Martin1701/AEEPROG/PCB/USB_mini_board.brd

## EAGLE design PCB/USB_mini_board.brd (2024-07-10)

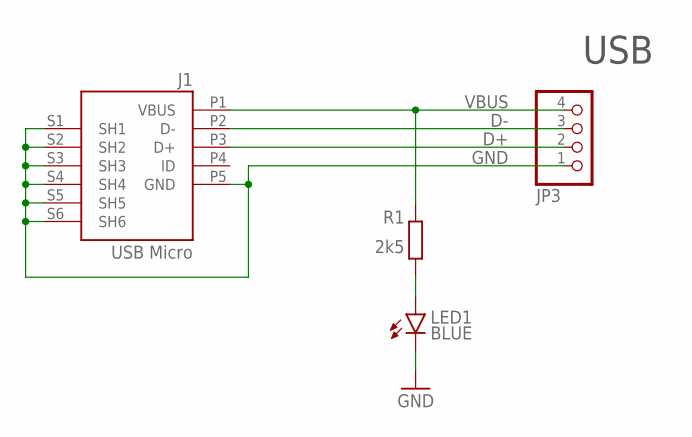
[picture p1: schematic USB_mini_board.sch]

Parts:
J1: USB Micro; CON2_USB_MICRO_B_AT
JP3: PINHD-1X4; 1X04
LED1: BLUE; CHIP-LED0805
R1: 2k5; R1206

Connections:
D+: J1.P3 (D+), JP3.2
D-: J1.P2 (D-), JP3.3
GND: J1.P5 (GND), J1.S1 (SH1), J1.S2 (SH2), J1.S3 (SH3), J1.S4 (SH4), J1.S5 (SH5), J1.S6 (SH6), JP3.1, LED1.C
unnamed: LED1.A, R1.2
VBUS: J1.P1 (VBUS), JP3.4, R1.1

Notes on the sheet:
USB

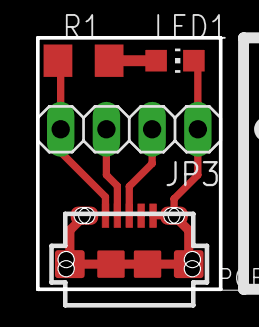
[picture p2: board USB_mini_board.brd from above]

Board: 2 copper layers, 10.2 x 14.0 mm, 4 parts (0 on the bottom side), 5 nets.
