Martin1701/AEEPROG/PCB/EEPROM_Programmer.brd

## EAGLE design PCB/EEPROM_Programmer.brd (2024-07-10)

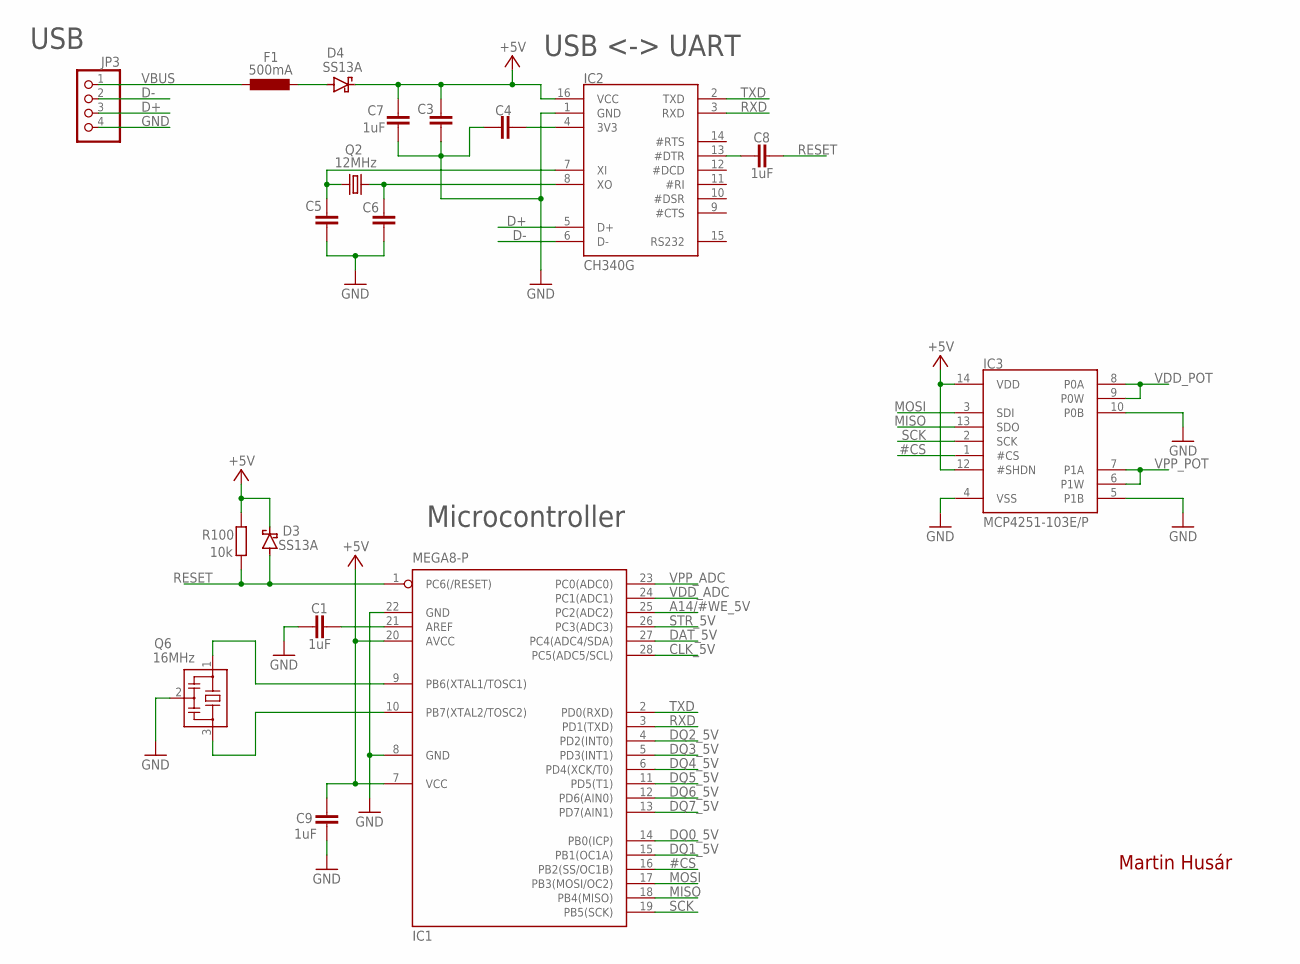
[picture p3: schematic EEPROM_Programmer.sch, sheet 1, USB to UART and Microcontroller]

Parts:
C1, C7, C8, C9: 1uF; C0805
C3, C4, C5, C6: C-EUC0603; C0603
D3, D4: SS13A; SOD-123_MINI-SMA
F1: 500mA; L1812
IC1: MEGA8-P; DIL28-3
IC2: CH340G; SOP16
IC3: MCP4251-103E/P; DIL14
JP3: PINHD-1X4; 1X04
Q2: 12MHz; HC49U-V
Q6: 16MHz; ZTTCS*MX
R100: 10k; R0805

Connections:
#CS: IC1.16 (PB2(SS/OC1B)), IC3.1 (#CS)
+5V: C3.2, C7.2, C9.2, D3.C, D4.C, IC1.7 (VCC), IC1.20 (AVCC), IC2.16 (VCC), IC3.12 (#SHDN), IC3.14 (VDD), R100.2; also elsewhere on the board
A14/#WE_5V: IC1.25 (PC2(ADC2)); also elsewhere on the board
CLK_5V: IC1.28 (PC5(ADC5/SCL)); also elsewhere on the board
D+: IC2.5 (D+), JP3.3
D-: IC2.6 (D-), JP3.2
DAT_5V: IC1.27 (PC4(ADC4/SDA)); also elsewhere on the board
DQ0_5V: IC1.14 (PB0(ICP)); also elsewhere on the board
DQ1_5V: IC1.15 (PB1(OC1A)); also elsewhere on the board
DQ2_5V: IC1.4 (PD2(INT0)); also elsewhere on the board
DQ3_5V: IC1.5 (PD3(INT1)); also elsewhere on the board
DQ4_5V: IC1.6 (PD4(XCK/T0)); also elsewhere on the board
DQ5_5V: IC1.11 (PD5(T1)); also elsewhere on the board
DQ6_5V: IC1.12 (PD6(AIN0)); also elsewhere on the board
DQ7_5V: IC1.13 (PD7(AIN1)); also elsewhere on the board
GND: C1.1, C3.1, C4.2, C5.2, C6.2, C7.1, C9.1, IC1.8 (GND), IC1.22 (GND), IC2.1 (GND), IC3.4 (VSS), IC3.5 (P1B), IC3.10 (P0B), JP3.4, Q6.2; also elsewhere on the board
MISO: IC1.18 (PB4(MISO)), IC3.13 (SDO)
MOSI: IC1.17 (PB3(MOSI/OC2)), IC3.3 (SDI)
unnamed: IC1.9 (PB6(XTAL1/TOSC1)), Q6.1
unnamed: IC1.10 (PB7(XTAL2/TOSC2)), Q6.3
unnamed: C1.2, IC1.21 (AREF)
unnamed: C8.1, IC2.13 (#DTR)
unnamed: C5.1, IC2.7 (XI), Q2.2
unnamed: C6.1, IC2.8 (XO), Q2.1
unnamed: C4.1, IC2.4 (3V3)
unnamed: D4.A, F1.2
RESET: C8.2, D3.A, IC1.1 (PC6(/RESET)), R100.1
RXD: IC1.3 (PD1(TXD)), IC2.3 (RXD)
SCK: IC1.19 (PB5(SCK)), IC3.2 (SCK)
STR_5V: IC1.26 (PC3(ADC3)); also elsewhere on the board
TXD: IC1.2 (PD0(RXD)), IC2.2 (TXD)
VBUS: F1.1, JP3.1
VDD_ADC: IC1.24 (PC1(ADC1)); also elsewhere on the board
VDD_POT: IC3.8 (P0A), IC3.9 (P0W); also elsewhere on the board
VPP_ADC: IC1.23 (PC0(ADC0)); also elsewhere on the board
VPP_POT: IC3.6 (P1W), IC3.7 (P1A); also elsewhere on the board

Notes on the sheet:
Martin Husár
USB
USB <-> UART
Microcontroller

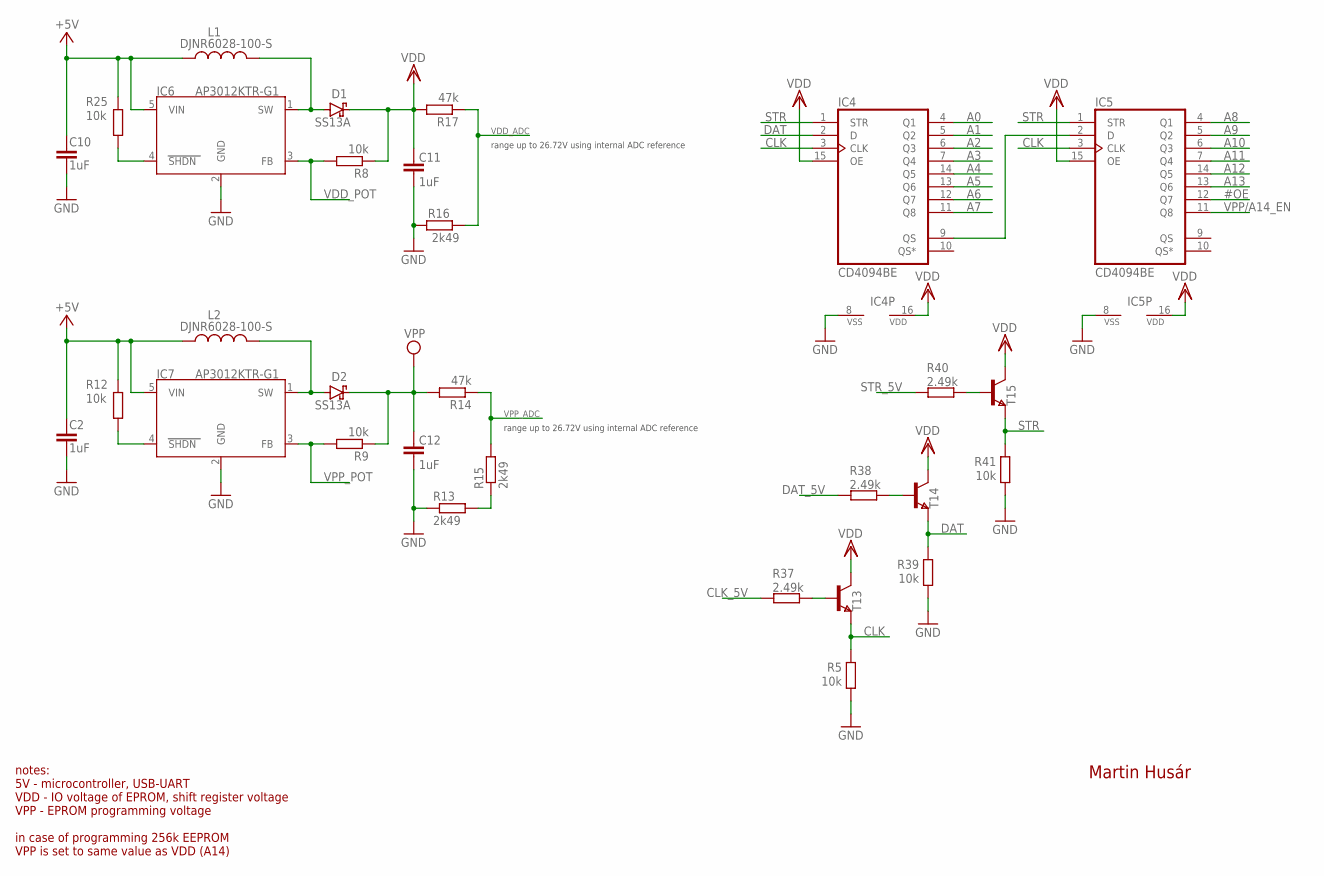
[picture p4: schematic EEPROM_Programmer.sch, sheet 2, Shift refisters and voltage converters]

Parts:
C2, C10, C11, C12: 1uF; C0805
D1, D2: SS13A; SOD-123_MINI-SMA
IC4, IC5: CD4094BE; DIL16
IC6, IC7: AP3012KTR-G1; SOT23-5
L1, L2: DJNR6028-100-S; INDUCTOR
R5, R8, R9, R12, R25, R39, R41: 10k; R0805
R13, R15, R16: 2k49; R0805
R14, R17: 47k; R1206
R37, R38, R40: 2.49k; R0805
T13, T14, T15: NPN; SOT-23

Connections:
#OE: IC5.12 (Q7); also elsewhere on the board
+5V: C2.1, C10.1, IC6.5 (VIN), IC7.5 (VIN), L1.P$1 (1), L2.P$1 (1), R12.2, R25.2; also elsewhere on the board
A0: IC4.4 (Q1); also elsewhere on the board
A1: IC4.5 (Q2); also elsewhere on the board
A2: IC4.6 (Q3); also elsewhere on the board
A3: IC4.7 (Q4); also elsewhere on the board
A4: IC4.14 (Q5); also elsewhere on the board
A5: IC4.13 (Q6); also elsewhere on the board
A6: IC4.12 (Q7); also elsewhere on the board
A7: IC4.11 (Q8); also elsewhere on the board
A8: IC5.4 (Q1); also elsewhere on the board
A9: IC5.5 (Q2); also elsewhere on the board
A10: IC5.6 (Q3); also elsewhere on the board
A11: IC5.7 (Q4); also elsewhere on the board
A12: IC5.14 (Q5); also elsewhere on the board
A13: IC5.13 (Q6); also elsewhere on the board
CLK: IC4.3 (CLK), IC5.3 (CLK), R5.2, T13.2 (E)
CLK_5V: R37.2; also elsewhere on the board
DAT: IC4.2 (D), R39.2, T14.2 (E)
DAT_5V: R38.2; also elsewhere on the board
GND: C2.2, C10.2, C11.2, C12.2, IC4.8 (VSS), IC5.8 (VSS), IC6.2 (GND), IC7.2 (GND), R5.1, R13.1, R16.1, R39.1, R41.1; also elsewhere on the board
unnamed: IC4.9 (QS), IC5.2 (D)
unnamed: D1.A, IC6.1 (SW), L1.P$2 (2)
unnamed: D2.A, IC7.1 (SW), L2.P$2 (2)
unnamed: R13.2, R15.1
unnamed: R38.1, T14.3 (B)
unnamed: R40.1, T15.3 (B)
unnamed: R37.1, T13.3 (B)
SHDN: IC6.4 (SHDN), R25.1
SHDN1: IC7.4 (SHDN), R12.1
STR: IC4.1 (STR), IC5.1 (STR), R41.2, T15.2 (E)
STR_5V: R40.2; also elsewhere on the board
VDD: C11.1, D1.C, IC4.15 (OE), IC4.16 (VDD), IC5.15 (OE), IC5.16 (VDD), R8.1, R17.2, T13.1 (C), T14.1 (C), T15.1 (C); also elsewhere on the board
VDD_ADC: R16.2, R17.1; also elsewhere on the board
VDD_POT: IC6.3 (FB), R8.2; also elsewhere on the board
VPP: C12.1, D2.C, R9.1, R14.2; also elsewhere on the board
VPP/A14_EN: IC5.11 (Q8); also elsewhere on the board
VPP_ADC: R14.1, R15.2; also elsewhere on the board
VPP_POT: IC7.3 (FB), R9.2; also elsewhere on the board

Notes on the sheet:
Martin Husár
range up to 26.72V using internal ADC reference
notes: 5V - microcontroller, USB-UART VDD - IO voltage of EPROM, shift register voltage VPP - EPROM programming voltage in case of programming 256k EEPROM VPP is set to same value as VDD (A14)

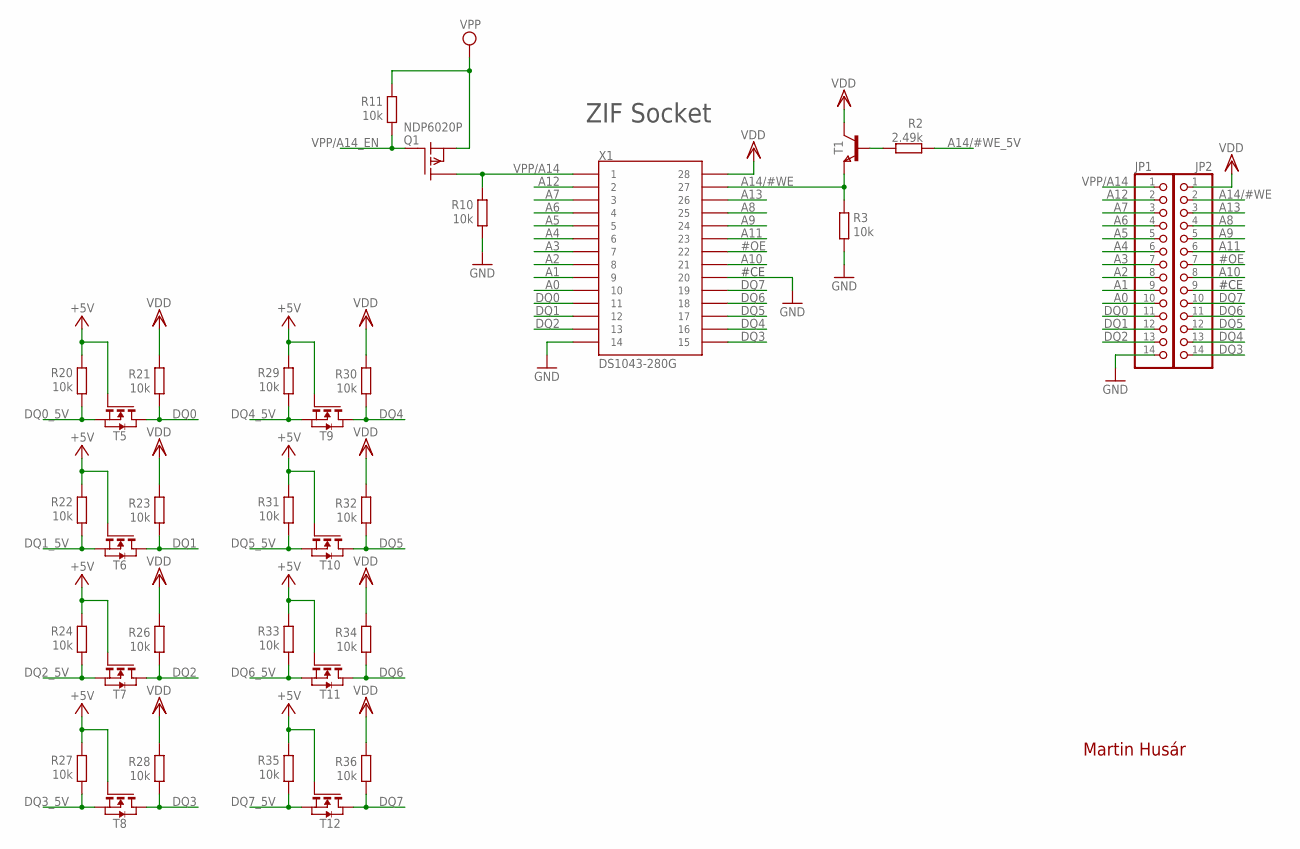
[picture p5: schematic EEPROM_Programmer.sch, sheet 3, EPROM/EEPROM socket]

Parts:
JP1, JP2: PINHD-1X14; 1X14
Q1: NDP6020P; TO220
R2: 2.49k; R0805
R3, R10, R11, R20, R21, R22, R23, R24, R26, R27, R28, R29, R30, R31, R32, R33, R34, R35, R36: 10k; R0805
T1: NPN; SOT-23
T5, T6, T7, T8, T9, T10, T11, T12: NMOSSOT23; SOT-23
X1: DS1043-280G

Connections:
#OE: JP2.7, X1.P22 (22); also elsewhere on the board
+5V: R20.2, R22.2, R24.2, R27.2, R29.2, R31.2, R33.2, R35.2, T5.3 (G), T6.3 (G), T7.3 (G), T8.3 (G), T9.3 (G), T10.3 (G), T11.3 (G), T12.3 (G); also elsewhere on the board
A0: JP1.10, X1.P10 (10); also elsewhere on the board
A1: JP1.9, X1.P9 (9); also elsewhere on the board
A2: JP1.8, X1.P8 (8); also elsewhere on the board
A3: JP1.7, X1.P7 (7); also elsewhere on the board
A4: JP1.6, X1.P6 (6); also elsewhere on the board
A5: JP1.5, X1.P5 (5); also elsewhere on the board
A6: JP1.4, X1.P4 (4); also elsewhere on the board
A7: JP1.3, X1.P3 (3); also elsewhere on the board
A8: JP2.4, X1.P25 (25); also elsewhere on the board
A9: JP2.5, X1.P24 (24); also elsewhere on the board
A10: JP2.8, X1.P21 (21); also elsewhere on the board
A11: JP2.6, X1.P23 (23); also elsewhere on the board
A12: JP1.2, X1.P2 (2); also elsewhere on the board
A13: JP2.3, X1.P26 (26); also elsewhere on the board
A14/#WE: JP2.2, R3.2, T1.2 (E), X1.P27 (27)
A14/#WE_5V: R2.2; also elsewhere on the board
DQ0: JP1.11, R21.1, T5.1 (D), X1.P11 (11)
DQ0_5V: R20.1, T5.2 (S); also elsewhere on the board
DQ1: JP1.12, R23.1, T6.1 (D), X1.P12 (12)
DQ1_5V: R22.1, T6.2 (S); also elsewhere on the board
DQ2: JP1.13, R26.1, T7.1 (D), X1.P13 (13)
DQ2_5V: R24.1, T7.2 (S); also elsewhere on the board
DQ3: JP2.14, R28.1, T8.1 (D), X1.P15 (15)
DQ3_5V: R27.1, T8.2 (S); also elsewhere on the board
DQ4: JP2.13, R30.1, T9.1 (D), X1.P16 (16)
DQ4_5V: R29.1, T9.2 (S); also elsewhere on the board
DQ5: JP2.12, R32.1, T10.1 (D), X1.P17 (17)
DQ5_5V: R31.1, T10.2 (S); also elsewhere on the board
DQ6: JP2.11, R34.1, T11.1 (D), X1.P18 (18)
DQ6_5V: R33.1, T11.2 (S); also elsewhere on the board
DQ7: JP2.10, R36.1, T12.1 (D), X1.P19 (19)
DQ7_5V: R35.1, T12.2 (S); also elsewhere on the board
GND: JP1.14, JP2.9, R3.1, R10.1, X1.P14 (14), X1.P20 (20); also elsewhere on the board
unnamed: R2.1, T1.3 (B)
VDD: JP2.1, R21.2, R23.2, R26.2, R28.2, R30.2, R32.2, R34.2, R36.2, T1.1 (C), X1.P28 (28); also elsewhere on the board
VPP: Q1.3 (S), R11.2; also elsewhere on the board
VPP/A14: JP1.1, Q1.2 (D), R10.2, X1.P1 (1)
VPP/A14_EN: Q1.1 (G), R11.1; also elsewhere on the board

Notes on the sheet:
Martin Husár
ZIF Socket
#CE

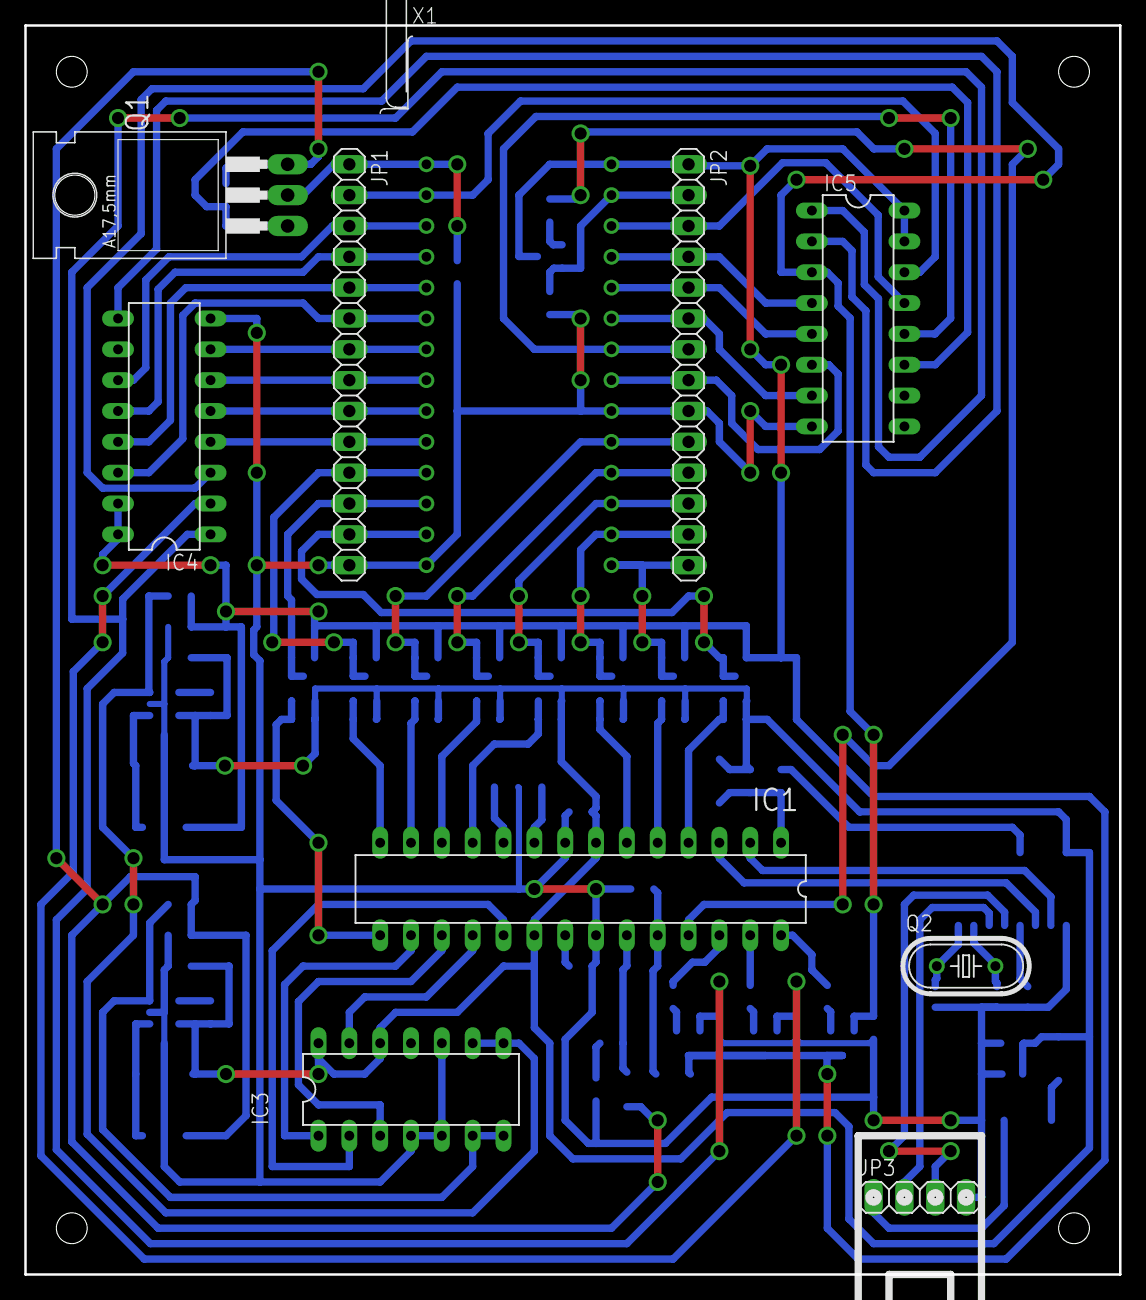
[picture p6: board EEPROM_Programmer.brd from above]

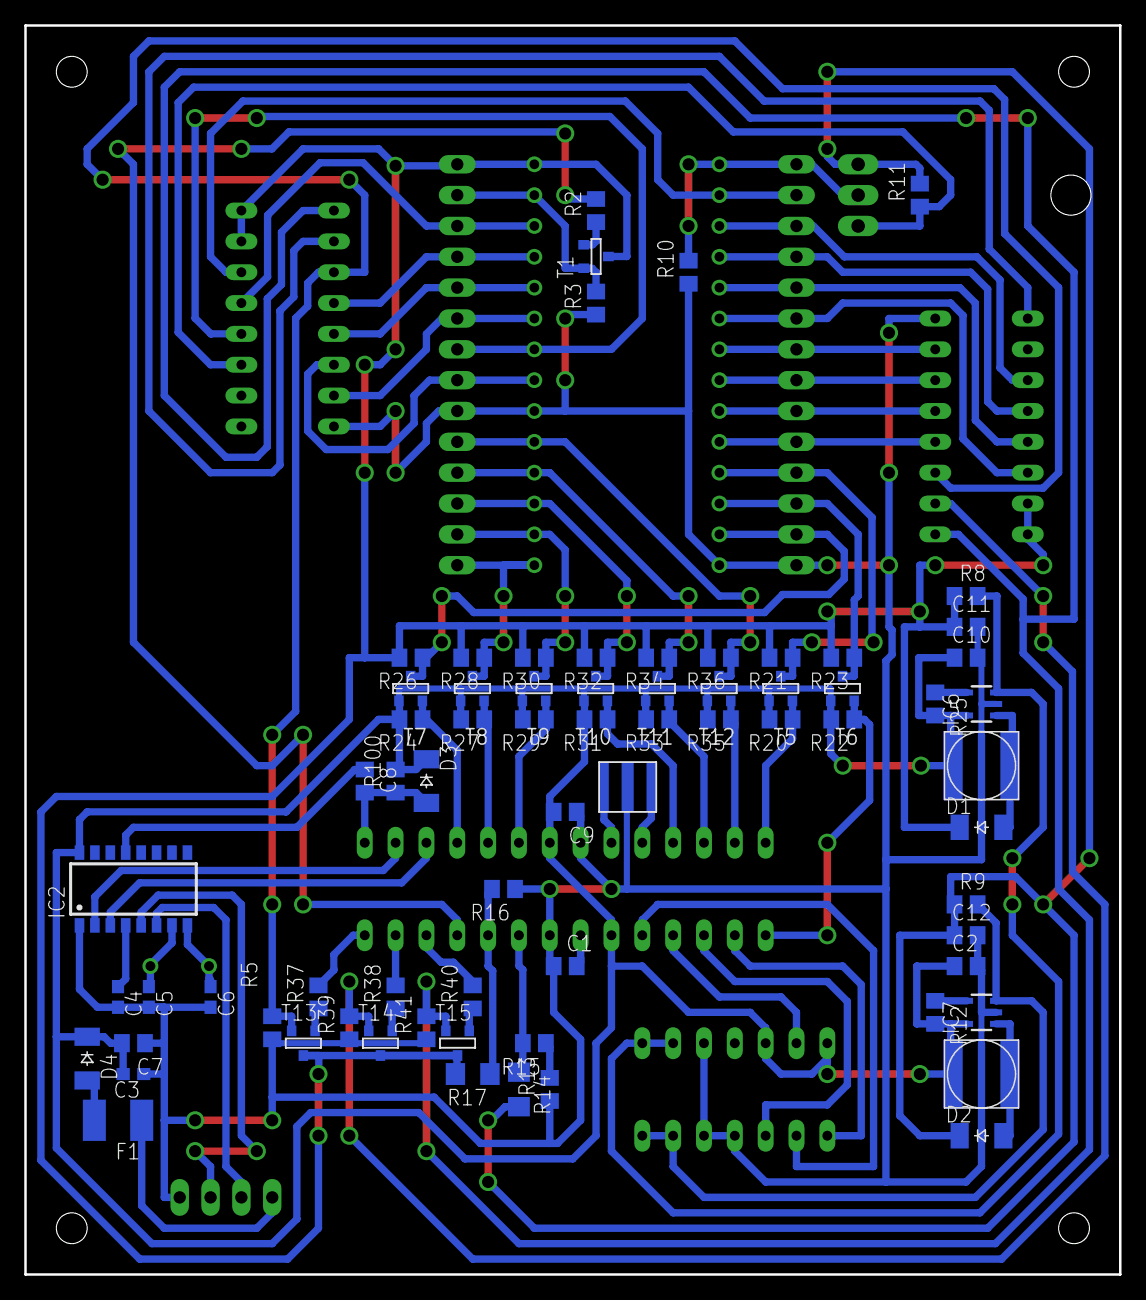
[picture p7: board EEPROM_Programmer.brd from below]

Board: 2 copper layers, 90.2 x 102.9 mm, 81 parts (71 on the bottom side), 77 nets.
