Martin1701/AEEPROG/(notices)

Notices in the files:
parts and their libraries:
Arduino-connectors: Copyright (c) 2016-2017 Arduino LLC. All right reserved.
